somaproject/network/docs/README

Docs organization

Commentary
IO: 
   Data input/output
   Serial interface
Implementation -- FPGA
implementation -- PCB
