somaproject/network/docs/tx/tx.tex

\section{Packet Transmission}
Packet transmission takes a packet from the generic interface and
places it on the wire via the GMII interface.

\import{.}{txinput.tex}

\import{.}{txoutput.tex}
