somaproject/network/docs/control/control.tex

\section{NIC Control}
NIC control manages

1. The management interface to the PHY
2. counters for various sytem-wide events
3. packet filtering and rx filtering
4. system LED illumination
5. the general serial management interface

The serial interface and address values for the NIC are described in the section {NIC Serial management protocol}

\subsection{implementation}
