somaproject/network/docs/rx/rxvalid.tex

The RXValid module reads in the data associated with a new frame a
byte at a time, and compares the destination MAC address to the
broadcast, multicast, and self-mac addresses. If the control inputs
allow for reception of the recovered MAC address, \signal{DESTOK} is
asserted. 

\begin{figure}
\label{rxvalid}

\caption{The RX Valid Interface, verifying correct packets}

\end{figure}

\begin{figure}
\label{rxvalidfsm}

\caption{The RX Valid FSM, verifying correct packets}
\end{figure}
