somaproject/network/docs/network.bomdb.ods

Network Project Summary
Total Device Count |  |  | 1
Quant | Desc | Vendor | Package | Val | Tol | Total | Distributor | Qty
57 | C0603C104J4RACTU | Kemet | 0603 | 0.1uF | 5% | 57
16 | C0402C103K3RACTU | Kemet | 0402 | 0.01uF | 10% | 16
11 | LTST-C170TBKT | Lumex | 0805 |  |  | 11
1 | 87832-1420 | Molex |  |  |  | 1
1 | ECS-3953M-500-B-TR | ECS, Inc | SMT |  |  | 1
1 | TPS79518DCQR | Texas Instruments | SOT-223-5 |  |  | 1
2 | TPS79525DCQ | Texas Instruments | SOT-223-5 |  |  | 2
1 | TPS79501DCQR | Texas Instruments | SOT-223-5 |  |  | 1
1 | 44050-0007 | Molex | RJ45 |  |  | 1
1 | H5007NL | Pulse | 24SOIC |  |  | 1
1 | DP83865DVH | National Semiconductor | 128PQFP |  |  | 1
1 | CY7C1350G-200AXC | Cypress | 100PQFP |  |  | 1
1 | XC3S200-4PQG208C | Xilinx | 208PQFP |  |  | 1
1 | MA-506 25.0000M-C0 | Epson Electronics America Inc | SMD |  |  | 1
2 | ECJ-1VC1H080D |  | 0603 | 8pF |  | 2
1 | MCR03EZPFX9761 | Rohm | 0603 | 9.76k | 1% | 1
4 | MCR03EZPFX3830 | Rohm | 0603 | 383 | 1% | 4
15 | ERJ-3EKF49R9V | Panasonic - ECG | 0603 | 49.9 | 1% | 15
7 | RC0603FR-072KL | Yaego America | 0603 | 2.00k | 1% | 7
4 | RC0603FR-0775RL | Yaego America | 0603 | 75 | 1% | 4
1 | RC0603FR-0710KL | Yaego America | 0603 | 10.0k | 1% | 1
1 | RC0603FR-0718RL | Yaego America | 0603 | 18.0 | 1% | 1
4 | GRM31MR71A225MA01L | muRata | 1206 | 2.2uF |  | 4
1 | TAJD226K025R | AVX corporation | 7343 | 22uF | 10% | 1
8 | TAJC106K020R | AVX corporation | 6032 | 10uF | 10% | 8
4 | B45197A2107K309 | Kemet | 6032 | 100uF | 10% | 4
1 | PPTC282LFBN-RC |  |  |  |  | 1
