somaproject/network/tests/blink/README

A test to blink the LEDs of the interface, to test booting.
