somaproject/network/tests/simplememtest/README

A simple test of our memory IO, to make sure all pins are functioning
properly and the like. 

The readout is accomplished via the JTAG BSCAN block on USER1.

We alternate read-write and then make sure we're reading/writing from
the correct location/value. The verify check is located one cycle in
the future.

Originally ported from code we had written for the backplane.
