somaproject/network/sim/components/GMII/results.txt

Error at time=724796ps MDIO=1, Expected = 0 
No errors or warnings
