somaproject/network/(list of files, drawings)

Other design files:
pcb/FPGA.SCHDOC
pcb/MAIN.SCHDOC
pcb/memory.SCHDOC
pcb/Network Interface.PRJPCB
pcb/NIC.PCBDOC
pcb/outputs/BOM.html-Network Interface.PRJPCB
pcb/outputs/BOM.text-Network Interface.PRJPCB
pcb/outputs/BOM.xls-Network Interface.PRJPCB
pcb/parts.PCBLIB
pcb/parts.SCHLIB
pcb/PHY.SCHDOC
pcb/Power and Clocks.SCHDOC
