somaproject/network/vhdl/network.vhd

library IEEE;
use IEEE.STD_LOGIC_1164.all;
use IEEE.STD_LOGIC_ARITH.all;
use IEEE.STD_LOGIC_UNSIGNED.all;

library UNISIM;
use UNISIM.VComponents.all;

entity network is
  port ( CLKIN     : in    std_logic;
         RX_DV     : in    std_logic;
         RX_ER     : in    std_logic;
         RXD       : in    std_logic_vector(7 downto 0);
         RX_CLK    : in    std_logic;
         TXD       : out   std_logic_vector(7 downto 0);
         TX_EN     : out   std_logic;
         GTX_CLK   : out   std_logic;
         MA        : out   std_logic_vector(16 downto 0);
         MD        : inout std_logic_vector(31 downto 0);
         MCLK      : out   std_logic;
         MWE       : out   std_logic;
         CLKIOIN   : in    std_logic;
         NEXTFRAME : in    std_logic;
         DOUT      : out   std_logic_vector(15 downto 0);
         DOUTEN    : out   std_logic;
         NEWFRAME  : in    std_logic;
         DIN       : in    std_logic_vector(15 downto 0);
         MDIO      : inout std_logic;
         MDC       : out   std_logic;
         LEDACT    : out   std_logic;
         LEDTX     : out   std_logic;
         LEDRX     : out   std_logic;
         LED100    : out   std_logic;
         LED1000   : out   std_logic;
         LEDDPX    : out   std_logic;
         LEDPOWER  : out   std_logic;
         PHYRESET  : out   std_logic;
         SCLK      : in    std_logic;
         SIN       : in    std_logic;
         SOUT      : out   std_logic;
         SCS       : in    std_logic);
end network;

architecture Behavioral of network is


  -- clock and timing signals
  signal clk, clkio, clklo, clkrx             : std_logic := '0';
  signal clkint, clkioint, clkloint, clkrxint : std_logic := '0';
  signal clkb, clkbint                        : std_logic := '0';
  signal clkf, clkfint                        : std_logic := '0';

  signal clk90, clk90int   : std_logic := '0';
  signal clk180, clk180int : std_logic := '0';
  signal clk270, clk270int : std_logic := '0';

  signal mclkint, mclkintfb : std_logic := '0';

  signal clken1, clken2, clken3, clken4 : std_logic := '0';

  -- data
  signal d1, d2, d3, d4, q1, q2, q3, q4 :
    std_logic_vector(31 downto 0) := (others => '0');

  -- addresses
  signal addr1 : std_logic_vector(15 downto 0) := (others => '0');
  signal addr2 : std_logic_vector(15 downto 0) := (others => '0');
  signal addr3 : std_logic_vector(15 downto 0) := (others => '0');
  signal addr4 : std_logic_vector(15 downto 0) := (others => '0');

  signal addr1ext : std_logic_vector(16 downto 0) := (others => '0');
  signal addr2ext : std_logic_vector(16 downto 0) := (others => '0');
  signal addr3ext : std_logic_vector(16 downto 0) := (others => '0');
  signal addr4ext : std_logic_vector(16 downto 0) := (others => '0');

  -- error and status signals
  signal rxcrcerr, rxoferr, rxphyerr, rxf, txf,
    txi_mwen, txfifowerr, rxfifowerr :
    std_logic := '0';


-- base pointers
  signal rxbp, txbp     : std_logic_vector(15 downto 0) :=
    (others => '0');
  signal txfbbp, rxfbbp : std_logic_vector(15 downto 0) :=
    (others => '0');
  signal txinmwen       : std_logic                     := '0';

  -- fifo control
  signal txfifofull, rxfifofull : std_logic := '0';

  -- mac address filtering
  signal rxmcast, rxbcast, rxucast, rxallf : std_logic := '0';

  signal macaddr : std_logic_vector(47 downto 0) := (others => '0');

  -- memory read/write error
  signal rxmemcrcerr, txmemcrcerr : std_logic := '0';
  signal txiocrcerr               : std_logic := '0';
  signal txiocrcerrpos : std_logic_vector(15 downto 0) := (others => '0');
  

  signal reset      : std_logic := '0';
  signal hilocked   : std_logic := '0';
  signal hireset    : std_logic := '1';
  signal multlocked : std_logic := '0';
  signal multreset  : std_logic := '1';


  component memory
    port ( CLK     : in    std_logic;
           RESET   : in    std_logic;
           DQEXT   : inout std_logic_vector(31 downto 0);
           WEEXT   : out   std_logic;
           ADDREXT : out   std_logic_vector(16 downto 0);
           ADDR1   : in    std_logic_vector(16 downto 0);
           ADDR2   : in    std_logic_vector(16 downto 0);
           ADDR3   : in    std_logic_vector(16 downto 0);
           ADDR4   : in    std_logic_vector(16 downto 0);
           D1      : in    std_logic_vector(31 downto 0);
           D2      : in    std_logic_vector(31 downto 0);
           D3      : in    std_logic_vector(31 downto 0);
           D4      : in    std_logic_vector(31 downto 0);
           Q1      : out   std_logic_vector(31 downto 0);
           Q2      : out   std_logic_vector(31 downto 0);
           Q3      : out   std_logic_vector(31 downto 0);
           Q4      : out   std_logic_vector(31 downto 0);
           WE1     : in    std_logic;
           WE2     : in    std_logic;
           WE3     : in    std_logic;
           WE4     : in    std_logic;
           CLKEN1  : out   std_logic;
           CLKEN2  : out   std_logic;
           CLKEN3  : out   std_logic;
           CLKEN4  : out   std_logic);
  end component;

  component RXinput
    port ( RX_CLK     : in  std_logic;
           CLK        : in  std_logic;
           RESET      : in  std_logic;
           RX_DV      : in  std_logic;
           RX_ER      : in  std_logic;
           RXD        : in  std_logic_vector(7 downto 0);
           MD         : out std_logic_vector(31 downto 0);
           MA         : out std_logic_vector(15 downto 0);
           BPOUT      : out std_logic_vector(15 downto 0);
           RXCRCERR   : out std_logic;
           RXOFERR    : out std_logic;
           RXPHYERR   : out std_logic;
           RXFIFOWERR : out std_logic;
           FIFOFULL   : in  std_logic;
           RXF        : out std_logic;
           MACADDR    : in  std_logic_vector(47 downto 0);
           RXBCAST    : in  std_logic;
           RXMCAST    : in  std_logic;
           RXUCAST    : in  std_logic;
           RXALLF     : in  std_logic);
  end component;

  component RXoutput
    port ( CLK       : in  std_logic;
           CLKEN     : in  std_logic;
           RESET     : in  std_logic;
           BPIN      : in  std_logic_vector(15 downto 0);
           FBBP      : out std_logic_vector(15 downto 0);
           MA        : out std_logic_vector(15 downto 0);
           MQ        : in  std_logic_vector(31 downto 0);
           CLKIO     : in  std_logic;
           MEMCRCERR : out std_logic;

           NEXTFRAME : in  std_logic;
           DOUT      : out std_logic_vector(15 downto 0);
           DOUTEN    : out std_logic);
  end component;

  component TXoutput
    port ( CLK       : in  std_logic;
           RESET     : in  std_logic;
           MQ        : in  std_logic_vector(31 downto 0);
           MA        : out std_logic_vector(15 downto 0);
           BPIN      : in  std_logic_vector(15 downto 0);
           TXD       : out std_logic_vector(7 downto 0);
           TXEN      : out std_logic;
           TXF       : out std_logic;
           MEMCRCERR : out std_logic;
           FBBP      : out std_logic_vector(15 downto 0);
           CLKEN     : in  std_logic);
  end component;

  component TXinput
    port ( CLK        : in  std_logic;
           CLKIO      : in  std_logic;
           RESET      : in  std_logic;
           DIN        : in  std_logic_vector(15 downto 0);
           NEWFRAME   : in  std_logic;
           MD         : out std_logic_vector(31 downto 0);
           MWEN       : out std_logic;
           MA         : out std_logic_vector(15 downto 0);
           BPOUT      : out std_logic_vector(15 downto 0);
           FIFOFULL   : in  std_logic;
           TXFIFOWERR : out std_logic;
           TXIOCRCERR : out std_logic;
           TXIOCRCERRPOS : out std_Logic_vector(15 downto 0); 
           DONE       : out std_logic);
  end component;

  component FIFOcheck
    port ( CLK      : in  std_logic;
           BP       : in  std_logic_vector(15 downto 0);
           FBBP     : in  std_logic_vector(15 downto 0);
           FIFOFULL : out std_logic);
  end component;

  component control
    port ( CLK         : in    std_logic;
           CLKLO       : in    std_logic;
           RESET       : in    std_logic;
           SCLK        : in    std_logic;
           SCS         : in    std_logic;
           SIN         : in    std_logic;
           SOUT        : out   std_logic;
           LEDACT      : out   std_logic;
           LEDTX       : out   std_logic;
           LEDRX       : out   std_logic;
           LED100      : out   std_logic;
           LED1000     : out   std_logic;
           LEDDPX      : out   std_logic;
           PHYRESET    : out   std_logic;
           TXF         : in    std_logic;
           RXF         : in    std_logic;
           TXFIFOWERR  : in    std_logic;
           RXFIFOWERR  : in    std_logic;
           RXPHYERR    : in    std_logic;
           RXOFERR     : in    std_logic;
           TXMEMCRCERR : in    std_logic;
           RXMEMCRCERR : in    std_logic;
           TXIOCRCERR  : in    std_logic;
           TXIOCRCERRPOS : in std_logic_vector(15 downto 0); 
           RXCRCERR    : in    std_logic;
           RXBCAST     : out   std_logic;
           RXMCAST     : out   std_logic;
           RXUCAST     : out   std_logic;
           RXALLF      : out   std_logic;
           MACADDR     : out   std_logic_vector(47 downto 0);
           MDIO        : inout std_logic;
           MDC         : out   std_logic;
           RXBP        : in    std_logic_vector(15 downto 0);
           TXBP        : in    std_logic_vector(15 downto 0);
           RXFBBP      : in    std_logic_vector(15 downto 0);
           TXFBBP      : in    std_logic_vector(15 downto 0));
  end component;

  signal memlocked, memreset : std_logic := '0';

  -- debugging :
  signal doutensig      : std_logic                     := '0';
  signal debugdouten    : std_logic                     := '0';
  signal debugnextframe : std_logic                     := '0';
  signal debugdout      : std_logic_vector(15 downto 0) := (others => '0');

  component datagen
    port (
      CLK       : in  std_logic;
      NEXTFRAME : in  std_logic;
      DOUTEN    : out std_logic;
      DOUT      : out std_logic_vector(15 downto 0)
      );
  end component;

begin

  DOUTEN <= doutensig;

  LEDPOWER <= '1';

  addr1ext <= ('1' & addr1);
  addr2ext <= ('0' & addr2);
  addr3ext <= ('1' & addr3);
  addr4ext <= ('0' & addr4);




  clkio_dcm : DCM
    port map (
      CLK0  => clkioint,                -- 0 degree DCM CLK ouptput
      CLKFB => clkio,                   -- DCM clock feedback
      CLKIN => CLKIOIN,
      RST   => RESET
      );

  clkio_bufg : BUFG
    port map (
      I => clkioint,
      O => clkio);


  clk_dcm : DCM
    generic map (
      CLKDV_DIVIDE   => 2.0,
      CLKFX_MULTIPLY => 5,
      CLKFX_DIVIDE   => 2)
    port map (
      CLK0           => clkbint,        -- 50 MHz dummy feedback loop
      CLKFB          => clkb,           -- 
      CLKIN          => CLKIN,
      CLKDV          => clkloint,
      CLKFX          => clkfint,        -- 125 Mhz generated clock
      RST            => '0',
      LOCKED         => multlocked
      );

  multreset <= not multlocked;

  clkhi_dcm : DCM
    port map (
      CLK0   => clkint,                 -- 0 degree DCM CLK ouptput
      CLKFB  => clk,                    -- DCM clock feedback
      CLK180 => clk180int,
      CLK90  => clk90int,
      CLK270 => clk270int,
      CLKIN  => clkf,
      RST    => multreset,
      LOCKED => hilocked
      );

  hireset <= not hilocked;


  clkf_bufg : BUFG port map (
    I => clkfint,
    O => clkf);

  clkb_bufg : BUFG port map (
    I => clkbint,
    O => clkb);

  clk_bufg : BUFG port map (
    I => clkint,
    O => clk);

  clklo_bufg : BUFG port map (
    I => clkloint,
    O => clklo);


  clk180_bufg : BUFG port map (
    I => clk180int,
    O => clk180 );

  U2 : OBUF port map (I => clk180, O => GTX_CLK);

  clkrx_bufg : BUFG port map (
    I => RX_CLK,
    O => clkrx);

  clkmem_dcm : DCM
    generic map (
      CLKOUT_PHASE_SHIFT => "FIXED",
      PHASE_SHIFT        => 100 )
    port map (
      CLK0               => mclkintfb,
      CLKFB              => mclkint,
      CLKIN              => clk,
      RST                => hireset,
      locked             => memlocked
      );
  memreset <= not memlocked;
  RESET    <= memreset;

  clkmem_bufg : BUFG port map (
    I => mclkintfb,
    O => mclkint);

  MCLK <= mclkint;

  memcontroller : memory port map (
    CLK     => clk,
    RESET   => RESET,
    DQEXT   => MD,
    WEEXT   => MWE,
    ADDREXT => MA,
    ADDR1   => addr1ext,
    ADDR2   => addr2ext,
    ADDR3   => addr3ext,
    ADDR4   => addr4ext,
    D1      => d1,
    D2      => d2,
    D3      => d3,
    D4      => d4,
    Q1      => q1,
    Q2      => q2,
    Q3      => q3,
    Q4      => q4,
    WE1     => '1',
    WE2     => '0',
    WE3     => '0',
    WE4     => '1',
    CLKEN1  => clken1,
    CLKEN2  => clken2,
    CLKEN3  => clken3,
    CLKEN4  => clken4);

  rx_input : rxinput port map (
    RX_CLK     => clkrx,
    CLK        => clk,
    RESET      => RESET,
    RX_DV      => RX_DV,
    RX_ER      => RX_ER,
    RXD        => RXD,
    MD         => d1,
    MA         => addr1,
    BPOUT      => rxbp,
    RXCRCERR   => rxcrcerr,
    RXOFERR    => rxoferr,
    RXPHYERR   => rxphyerr,
    FIFOFULL   => rxfifofull,
    RXFIFOWERR => rxfifowerr,
    RXF        => rxf,
    MACADDR    => macaddr,
    RXBCAST    => rxbcast,
    RXMCAST    => rxmcast,
    RXUCAST    => rxucast,
    RXALLF     => rxallf);

  rx_output : rxoutput port map (
    CLK       => clk,
    CLKEN     => clken3,
    RESET     => RESET,
    BPIN      => rxbp,
    FBBP      => rxfbbp,
    MA        => addr3,
    MQ        => q3,
    MEMCRCERR => rxmemcrcerr,
    CLKIO     => clkio,
    NEXTFRAME => NEXTFRAME,
    DOUT      => DOUT,
    DOUTEN    => doutensig);

  tx_output : txoutput
    port map (
      CLK       => clk,
      RESET     => reset,
      MQ        => q2,
      MA        => addr2,
      BPIN      => txbp,
      TXD       => TXD,
      TXEN      => TX_EN,
      TXF       => txf,
      MEMCRCERR => txmemcrcerr,
      FBBP      => txfbbp,
      CLKEN     => clken2);

  txinput_inst : txinput
    port map (
      CLK        => clk,
      CLKIO      => clkio,
      RESET      => reset,
      DIN        => DIN,
      NEWFRAME   => NEWFRAME,
      MWEN       => txinmwen,
      MA         => addr4,
      MD         => d4,
      BPOUT      => txbp,
      FIFOFULL   => txfifofull,
      TXFIFOWERR => txfifowerr,
      TXIOCRCERR => txiocrcerr,
      TXIOCRCERRPOS => txiocrcerrpos, 
      DONE       => open);

  tx_fifocheck : FIFOcheck port map(
    CLK      => clk,
    FIFOFULL => txfifofull,
    BP       => txbp,
    FBBP     => txfbbp);

  rx_fifocheck : FIFOcheck port map(
    CLK      => clk,
    FIFOFULL => rxfifofull,
    BP       => rxbp,
    FBBP     => rxfbbp);

  maccontrol : control port map (
    CLK         => clk,
    CLKLO       => clklo,
    RESET       => RESET,
    SCLK        => SCLK,
    SCS         => SCS,
    SIN         => SIN,
    SOUT        => SOUT,
    LEDACT      => LEDACT,
    LEDTX       => LEDTX,
    LEDRX       => LEDRX,
    LED100      => LED100,
    LED1000     => LED1000,
    LEDDPX      => LEDDPX,
    PHYRESET    => PHYRESET,
    TXF         => txf,
    RXF         => rxf,
    TXFIFOWERR  => txfifowerr,
    RXFIFOWERR  => rxfifowerr,
    RXPHYERR    => rxphyerr,
    RXOFERR     => rxoferr,
    RXCRCERR    => rxcrcerr,
    RXBCAST     => rxbcast,
    RXMCAST     => rxmcast,
    RXUCAST     => rxucast,
    RXALLF      => rxallf,
    RXMEMCRCERR => rxmemcrcerr,
    TXMEMCRCERR => txmemcrcerr,
    TXIOCRCERR  => txiocrcerr,
    TXIOCRCERRPOS => txiocrcerrpos, 
    MACADDR     => macaddr,
    MDIO        => MDIO,
    MDC         => MDC,
    RXBP        => rxbp,
    TXBP        => txbp,
    RXFBBP      => rxfbbp,
    TXFBBP      => txfbbp);




end Behavioral;
