somaproject/network/ping/vhdl/rambuffer.vhd

library IEEE;
use IEEE.STD_LOGIC_1164.ALL;
use IEEE.STD_LOGIC_ARITH.ALL;
use IEEE.STD_LOGIC_UNSIGNED.ALL;

--  Uncomment the following lines to use the declarations that are
--  provided for instantiating Xilinx primitive components.
library UNISIM;
use UNISIM.VComponents.all;

entity rambuffer is
    Port ( CLK : in std_logic;
	 		  RESET : in std_logic; 
           DIN : in std_logic_vector(15 downto 0);
           DOUT : out std_logic_vector(15 downto 0);
           WE : in std_logic;
           ADDR : in std_logic_vector(10 downto 0));
end rambuffer;

architecture Behavioral of rambuffer is
-- RAMBUFFER.VHD -- simple wrapper around BlockSelect+ RAMs to make a 1536x16 ram. 

	signal raddr : std_logic_vector(7 downto 0) := (others => '0');
	signal we0, we1, we2, we3, we4, we5 : std_logic := '0';
	signal dout0, dout1, dout2, dout3, dout4, dout5 : 
			std_logic_vector(15 downto 0) := (others => '0');


	component RAMB4_S16
	  generic (
	       INIT_00 : bit_vector := X"0000000000000000000000000000000000000000000000000000000000000000";
	       INIT_01 : bit_vector := X"0000000000000000000000000000000000000000000000000000000000000000";
	       INIT_02 : bit_vector := X"0000000000000000000000000000000000000000000000000000000000000000";
	       INIT_03 : bit_vector := X"0000000000000000000000000000000000000000000000000000000000000000";
	       INIT_04 : bit_vector := X"0000000000000000000000000000000000000000000000000000000000000000";
	       INIT_05 : bit_vector := X"0000000000000000000000000000000000000000000000000000000000000000";
	       INIT_06 : bit_vector := X"0000000000000000000000000000000000000000000000000000000000000000";
	       INIT_07 : bit_vector := X"0000000000000000000000000000000000000000000000000000000000000000";
	       INIT_08 : bit_vector := X"0000000000000000000000000000000000000000000000000000000000000000";
	       INIT_09 : bit_vector := X"0000000000000000000000000000000000000000000000000000000000000000";
	       INIT_0A : bit_vector := X"0000000000000000000000000000000000000000000000000000000000000000";
	       INIT_0B : bit_vector := X"0000000000000000000000000000000000000000000000000000000000000000";
	       INIT_0C : bit_vector := X"0000000000000000000000000000000000000000000000000000000000000000";
	       INIT_0D : bit_vector := X"0000000000000000000000000000000000000000000000000000000000000000";
	       INIT_0E : bit_vector := X"0000000000000000000000000000000000000000000000000000000000000000";
	       INIT_0F : bit_vector := X"0000000000000000000000000000000000000000000000000000000000000000");

	  port (DI     : in STD_LOGIC_VECTOR (15 downto 0);
	        EN     : in STD_logic;
	        WE     : in STD_logic;
	        RST    : in STD_logic;
	        CLK    : in STD_logic;
	        ADDR   : in STD_LOGIC_VECTOR (7 downto 0);
	        DO     : out STD_LOGIC_VECTOR (15 downto 0)); 
	end component;

	

begin
	raddr <= ADDR(7 downto 0); 
	we0 <= '1' when WE = '1' and ADDR(9 downto 7) = "000" else '0';
	we1 <= '1' when WE = '1' and ADDR(9 downto 7) = "001" else '0';
	we2 <= '1' when WE = '1' and ADDR(9 downto 7) = "010" else '0';
	we3 <= '1' when WE = '1' and ADDR(9 downto 7) = "011" else '0';
	we4 <= '1' when WE = '1' and ADDR(9 downto 7) = "100" else '0';
	we5 <= '1' when WE = '1' and ADDR(9 downto 7) = "101" else '0';

	process(CLK) is
	variable addrlsub : std_logic_vector(2 downto 0); 
	begin
	  if rising_edge(CLK) then 
	  		addrlsub := ADDR(9 downto 7); 
		end if; 
	      case addrlsub is
				when "000" => DOUT <= dout0; 
				when "001" => DOUT <= dout0; 
				when "010" => DOUT <= dout0; 
				when "011" => DOUT <= dout0; 
				when "100" => DOUT <= dout0; 
				when "101" => DOUT <= dout0; 
				when others => DOUT <= (others => '0');
			end case; 

   end process; 
	ram0 : RAMB4_S16 generic map (
				INIT_00 => X"0000000000000000000000000000000000000000000000000000000000000000",
				INIT_01 => X"0000000000000000000000000000000000000000000000000000000000000000",
				INIT_02 => X"0000000000000000000000000000000000000000000000000000000000000000",
				INIT_03 => X"0000000000000000000000000000000000000000000000000000000000000000",
				INIT_04 => X"0000000000000000000000000000000000000000000000000000000000000000",
				INIT_05 => X"0000000000000000000000000000000000000000000000000000000000000000",
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
				INIT_0F => X"0000000000000000000000000000000000000000000000000000000000000000")
				port map (
				DI => DIN,
				EN => '1',
				WE => we5,
				RST => RESET,
				CLK => CLK,
				ADDR => raddr,
				DO => dout5); 

				
				 




end Behavioral;
