somaproject/network/vhdl/rxvalid.vhd

library IEEE;
use IEEE.STD_LOGIC_1164.all;
use IEEE.STD_LOGIC_ARITH.all;
use IEEE.STD_LOGIC_UNSIGNED.all;

entity RXValid is
  port ( CLK     : in  std_logic;
         RESET   : in  std_logic;
         DATA    : in  std_logic_vector(7 downto 0);
         MACADDR : in  std_logic_vector(47 downto 0);
         RXBCAST : in  std_logic;
         RXMCAST : in  std_logic;
         RXUCAST : in  std_logic;
         RXALLF  : in  std_logic;
         DESTOK  : out std_logic;
         FD      : in  std_logic;
         NEXTF   : in  std_logic);
end RXValid;

architecture Behavioral of RXValid is
-- RXVALID.VHD
-- latches in the DEST MAC and determines
-- if we should receive this frame

  -- MAC latching
  signal datal       : std_logic_vector(47 downto 0)
                                                    := (others => '0');
  signal bcast, mcast, maceq, lbcast, lmcast, lmaceq
                     : std_logic_vector(5 downto 0) := (others => '0');
  signal fdl, nextfl : std_logic                    := '0';
  signal dl          : std_logic_vector(7 downto 0)
                                                    := (others => '0');
  -- input latching
  signal macaddrl    : std_logic_vector(47 downto 0)
                                                    := (others => '0');
  signal rxbcastl, rxucastl, rxmcastl, rxallfl
                     : std_logic                    := '0';
  signal validbcast, validmcast, validucast
                     : std_logic                    := '0';

  type states is (none, byte0, byte1,
                  byte2, byte3, byte4, byte5);
  signal cs, ns : states := none;


begin
  clock : process(RESET, CLK)
  begin
    if RESET = '1' then
      cs   <= none;
    else
      if rising_edge(CLK) then
        cs <= ns;

        -- inputs
        macaddrl <= MACADDR;
        rxbcastl <= RXBCAST;
        rxmcastl <= RXMCAST;
        rxucastl <= RXUCAST;
        rxallfl  <= RXALLF;

        -- valids
        if bcast = "111111" then
          validbcast <= '1';
        else
          validbcast <= '0';
        end if;

        if mcast(0) = '1' then
          validmcast <= '1';
        else
          validmcast <= '0';
        end if;

        if maceq = "111111" then
          validucast <= '1';
        else
          validucast <= '0';
        end if;

        if (validbcast = '1' and rxbcastl = '1')
          or (validmcast = '1' and rxmcastl = '1')
          or (validucast = '1' and rxucastl = '1')
          or rxallfl = '1' then
          DESTOK <= '1';
        else
          DESTOK <= '0';
        end if;

        -- comparisons
        bcast  <= lbcast;
        mcast  <= lmcast;
        maceq  <= lmaceq;
        dl     <= DATA;
        fdl    <= FD;
        nextfl <= NEXTF;

        if cs = byte0 and fdl = '1' then
          datal(47 downto 40) <= dl;
        end if;
        if cs = byte1 and fdl = '1' then
          datal(39 downto 32) <= dl;
        end if;
        if cs = byte2 and fdl = '1' then
          datal(31 downto 24) <= dl;
        end if;
        if cs = byte3 and fdl = '1' then
          datal(23 downto 16) <= dl;
        end if;
        if cs = byte4 and fdl = '1' then
          datal(15 downto 8)  <= dl;
        end if;
        if cs = byte5 and fdl = '1' then
          datal(7 downto 0)   <= dl;
        end if;
      end if;
    end if;
  end process clock;


  comparisons : for n in 0 to 5 generate
  begin
    lbcast(n) <= '1' when
                 datal(47 - 8*n downto 40 - 8*n) = "11111111" else '0';
    lmcast(n) <= '1' when
                 datal(47 - 8*n downto 40 - 8*n) = "00000001" else '0';
    lmaceq(n) <= '1' when
                 datal(47 - 8*n downto 40 - 8*n) =
                 macaddrl(47 - 8*n downto 40 - 8*n)
                 else '0';
  end generate;


  fsm : process(cs, nextfl, fdl) is
  begin
    case cs is
      when none   =>
        if nextfl = '1' then
          ns   <= byte0;
        else
          ns   <= none;
        end if;
      when byte0  =>
        if nextfl = '1' then
          ns   <= byte0;
        else
          if fdl = '1' then
            ns <= byte1;
          else
            ns <= byte0;
          end if;
        end if;
      when byte1  =>
        if nextfl = '1' then
          ns   <= byte0;
        else
          if fdl = '1' then
            ns <= byte2;
          else
            ns <= byte1;
          end if;
        end if;
      when byte2  =>
        if nextfl = '1' then
          ns   <= byte0;
        else
          if fdl = '1' then
            ns <= byte3;
          else
            ns <= byte2;
          end if;
        end if;
      when byte3  =>
        if nextfl = '1' then
          ns   <= byte0;
        else
          if fdl = '1' then
            ns <= byte4;
          else
            ns <= byte3;
          end if;
        end if;
      when byte4  =>
        if nextfl = '1' then
          ns   <= byte0;
        else
          if fdl = '1' then
            ns <= byte5;
          else
            ns <= byte4;
          end if;
        end if;
      when byte5  =>
        if nextfl = '1' then
          ns   <= byte0;
        else
          if fdl = '1' then
            ns <= none;
          else
            ns <= byte5;
          end if;
        end if;
      when others =>
        ns     <= none;
    end case;
  end process fsm;

end Behavioral;
