somaproject/network/sim/txoutput/txoutput.py

#!/usr/bin/python


import sys
sys.path.append("../../crc/code/")
import frame
import random
import struct
import numpy


def generateCRC(data):
    """ Takes in data and appends the crc

    """
    # create the string:
    d = ""
    for i in data:
        d += chr(i)
        
    fcs = frame.generateFCS(d)
    
    return [ord(fcs[0]),  ord(fcs[1]), ord(fcs[2]), ord(fcs[3])]

filename = "basic"

ramfile = file("%s.ram.dat" % filename, 'w')
bpfile = file("%s.bp.dat" % filename, 'w')
gmiifile = file("%s.gmii.dat" % filename, 'w')

ramaddr = 0; 

for i in range(255):
    crcerror = False
    if random.random() > 0.85:
        crcerror = True
    framedatalen = i + 56
        
    framedata = range(framedatalen)

    for i in range(framedatalen):
        framedata[i] = i % 256 #random.randint(0, 255)

    destmacaddr = range(6)
    srcmacaddr =  range(6)
    for i in range(6):
        destmacaddr[i] = random.randint(0, 255)
        srcmacaddr[i] = random.randint(0, 255)

    protocol = [8, 0]
        
    
    totaldata = destmacaddr + srcmacaddr + protocol + framedata
    crc = generateCRC(totaldata)
    totaldata = totaldata + crc
    totallen = len(totaldata)
    totaldata += [0, 0, 0, 0] # extra padding so ram write has enough to add
    if crcerror:
        print "generating a CRC error"
        totaldata[5] += 1
    
    # write the current ram address as a bp
    bpfile.write("%d %d %d\n" % (ramaddr, totallen, crcerror))


    # write the ram :
    
    ramfile.write("%04X %08X\n" % (ramaddr, totallen))
    ramaddr += 1
    
    for i in range((totallen+3) / 4) : # extra +3 such that odd lens work
        
        ramfile.write("%04X %02X%02X%02X%02X\n" % (ramaddr,
                                             totaldata[i*4+2],
                                             totaldata[i*4+3],
                                             totaldata[i*4+0],
                                             totaldata[i*4+1]))
        ramaddr += 1

    # GMII output
    totalbindata = ""
    for i in (framedata) :
        totalbindata += struct.pack("B", i)
    
    f = frame.frame(destmacaddr, srcmacaddr, 0x0800, totalbindata)
    framebin = f.getWire()
    for i in framebin:
        gmiifile.write('%02X ' % struct.unpack('B', i)[0])

    gmiifile.write('\n')

    
