somaproject/network/sim/components/NoBLram/NoBLSRAM.vhd

library IEEE;
use IEEE.STD_LOGIC_1164.all;
use ieee.numeric_std.all;
use std.textio.all;

use ieee.std_logic_textio.all;

library UNISIM;
use UNISIM.VComponents.all;

entity NoBLSRAM is
  generic ( FILEIN       :       string  := "SRAM_in.dat";
            FILEOUT      :       string  := "SRAM_out.dat";
            physical_sim :       integer := 0;
            TSU          :       time;
            THD          :       time;
            TKQ          :       time;
            TKQX         :       time);
  port ( CLK             : in    std_logic;
         DQ              : inout std_logic_vector(31 downto 0);
         ADDR            : in    std_logic_vector(16 downto 0);
         WE              : in    std_logic;
         RESET           : in    std_logic;
         SAVE            : in    std_logic);
end NoBLSRAM;

architecture Behavioral of NoBLSRAM is
-- another ram simulation. filein is our input file, fileout is
-- where we save to. filein is read on startup, fileout is
-- saved. This is ram designed to behave like Cypresses NoBL
-- (i.e. micron ZBT) sync SRAM
  subtype word is std_logic_vector(31 downto 0);

  type storage_array is
    array ( 0 to 131071) of word;

  signal IN_SIG, OUT_SIG, T_ENABLE :       std_logic;
  component IOBUF
    port (I, T                     : in    std_logic;
          O                        : out   std_logic;
          IO                       : inout std_logic);
  end component;
  signal din, dout                 :       word := (others => '0');

  signal lladdr, laddr, addr_now : std_logic_vector(16 downto 0) := (others => '0');
  signal llwe, lwe, we_now       : std_logic                     := '1';

-- times, from cypress 133 MHz part:


begin

  buffs        : for i in 0 to 31 generate
    buffs_inst : iobuf port map (
      I  => dout(i),
      O  => din(i),
      IO => DQ(i),
      T  => T_ENABLE);

  end generate;


  process(clk)
  begin

    if rising_edge(clk'delayed(THD)) then
      assert DQ'last_event >= THD
        report("Hold violation on DQ");
    end if;

  end process;

  -- cancel timings if this isn't a physical simulation



  main : process

    type load_file_type is file of word;
    type save_file_type is file of word;
    file load_file  : text open read_mode is FILEIN;
    file save_file  : text open write_mode is FILEOUT;
    variable WL, RL : line;

    variable index      : natural;
    variable dword      : bit_vector(31 downto 0);
    variable SRAM       : storage_array := (others => "00000000000000000000000000000000");
    variable numaddress : integer       := 0;


  begin
    wait until falling_edge(RESET);
    index     := 0;
    for i in 0 to 131071 loop
      SRAM(i) := (others => '0');       -- zero sram
    end loop;

    while not endfile(load_file) loop
      readline(load_file, RL);
      read(RL, dword);
      SRAM(index) := to_x01(dword);
      index       := index + 1;
    end loop;


    -- falling edge starts cmd; read in 8 bits, then decide what to do
    while true loop
      wait until rising_edge(CLK) or rising_edge(SAVE);
      if rising_edge(SAVE) then
        for i in 0 to 131071 loop
          write (WL, to_bitvector(SRAM(i)));
          write(WL, character(' '));
          hwrite(WL, SRAM(i));
          writeline(save_file, WL);

        end loop;
      end if;
      if rising_edge(CLK) then


        if physical_sim = 1 then
          assert(din'last_event >= TSU);
          report ("setup violation on din");
        end if;
        numaddress := to_integer(unsigned(laddr));
        dout <= (others => 'U')  after TKQX;
        dout <= SRAM(numaddress) after TKQ;

        T_ENABLE <= (not lwe) after 0 ns;

        if llwe = '0' then              -- a write
          --report "Writing to " & integer'image(to_integer(unsigned(lladdr)));
          --report "value = " & integer'image(to_integer(unsigned(din)));
          SRAM(to_integer(unsigned(lladdr))) := din;
        end if;

      end if;
    end loop;

    wait;

  end process main;

  clock : process(CLK)
  begin
    if rising_edge(CLK) then
      llwe <= lwe;
      lwe  <= WE;

      lladdr <= laddr;
      laddr  <= ADDR;

    end if;

  end process clock;
end Behavioral;
