somaproject/network/(commit log)

2003-03-27 First-approximation of memory controller; works in behavioral and translate sims. Can't do others because there is insufficnet IO on any synthesizable devices. Use really cool ZBT vhdl behavioral mod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
2003-03-30 ALU functions, reg file functions, about to begin modifying ALU for better timing. Currently it takes 16.7 ns, ouch
2003-03-30 Switching to computation with separate units (ALU, Logic, and shift) and using mux on output saved 2 ns
2003-03-30 CPU mostly done, will synthesize/translate with a period of 25 ns without too much difficulty in an XC2S50E device
2003-03-31 Upgraded to a 32-bit processor. We're having some trouble meeting the 30 ns constraint in the -6 grade device, but the -7 grade device comes in under 27 ns minimum period. Now, oddly, a -6 grade devi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
2003-03-31 Device successfully adds to numbers; can be constrained to fit inside of a Spartan-IIE 50, which is great in terms of resource utilization. Now working on serial interface so we can easily load outpu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
2003-03-31 Can successfully assemble simple adder, in test.asm.pl
2003-04-04 Testbench correctly reads in .hex assembled code
2003-08-10 basics of Network TX input working; now to add the NEWFRAME reset code and hopefully not slow things down too much. Currently will synthesize, P&R at 160 Mhz!
2003-08-11 Beginnings of GigE card, made much easier by previously figuring out what components I wanted for the old MACandPHY appraoch.
    [FPGA.SCHDOC, Network Interface.PRJPCB, PHY.SCHDOC, memory.SCHDOC]
2003-08-11 Schematics mostly done; now time to PCB!
    [FPGA.SCHDOC, Power and Clocks.SCHDOC]
2003-08-12 Schematic done; PCB layed out and passing DRC with flying colors. I'd love to verify the sizes on those larger tantalum caps -- I could probably go with some smaller ones there, but oh well.
    [FPGA.SCHDOC, MAIN.SCHDOC, NIC.PCBDOC, Network Interface.PRJPCB, PHY.SCHDOC, Power and Clocks.SCHDOC, memory.SCHDOC]
2003-08-12 Done, with new capacitors, LDOs which actually work, and large electrolytics. Standardized on a bus architecture for the HD68 connector
    [FPGA.SCHDOC, NIC.PCBDOC, Network Interface.PRJPCB, PHY.SCHDOC, Power and Clocks.SCHDOC]
2003-08-13 reannotated part numbers on PCB
    [NIC.PCBDOC]
2003-08-25 Well, we're almost there! CRC errors are the big issue at the moment -- there is some really funky bit-manipulation stuff going on and we need to check it out. The issue is that the CRC is to be sent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
2003-08-25 We can transmit packets correctly of 12, 13, 14, and 15 bytes, and I assume this will generalize to larger packets :) FRAMETX signal is useful for counters.
2003-09-09 RXinput_memio debugging has progressed; timing and synthesis work.
    Overview modified to reflect current system design.
2003-09-13 Some additional notes on software, camera
    Designed RX output side-- again, crossing clock boundaries sucks.
2003-09-16 created network.vhd, overview to begin complete system integration.
    Cleaned up the naming of a lot of signals, so there's system-wide uniformity.
    Added clock-boundary-crossing logic to soma network tx input; better-commented protocol in readme.txt.
    Added pullup resistor for I2C MII management interface on PCBs for network.
    [NIC.PCBDOC, PHY.SCHDOC]
2003-09-20 Modified some systems to meet timing constraints; network will synthesize at 7.5 ns, but that's just really really tight. I think I'll work on functional benchmarks and test vectors for a while.
    [memory.vhd, network.vhd]
2003-09-21 Wow, this was a hell of a lot of work. We've created a testbench and begun debugging larger chunks of the system. in particular, we've added fifocheck to prevent the system FIFOs from overwriting the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
    [network.vhd]
2003-09-23 Fixed memory problem -- I really did need to CE the DQs on their actual CEs. (i.e. D1 on CLKEN1, etc)
    Really screwed with the timing and layout of RX_Output, and now it works as expected. I think I know what that is.
    Added pins to network.ucf.
    Wow, entire thing synthesizes after I added the pins. Thats so funny -- i must have gained 500 ps just by placing the output pins logically.
    Device will both send and receive packets, and does correct (I think) CRC checking.
    [memory.vhd, network.vhd, test_NoBLSRAM.vhd]
2003-09-23 Fixed a few small issues with both PCBs, including renaming of parts designators and making sure top overlay silkscreen wasn't covering up solder pads :) The folder mask expansions here are 4 mil, wh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
    Generated output gerbers, zipped them, let's rock and roll!
    [NIC.PCBDOC, Network Interface.PRJPCB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]
2003-09-23 A great day.
    Got system TXing and RXing packets. Wrote some great test vector code, so we can directly diff input and output.
    Big problem: at the moment, RX_output will, after a certain packet or two, essentially skip a word and accidentally set its BP too high. This causes it to read in the value after the BP as the length, and all hell breaks loose.
    This could be due to a few things. First, since I'm using the output of the TX_OUT section (GMII vectors are compatable that way), I occasionally get packets separated by a _single cycle_ of TX_EN being 0. Now, I can't find much in the spec, but I'm pretty sure this is legal.
    Therefor, the current thought is maybe RX_INPUT isn't handling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
    [test_NoBLSRAM.vhd]
2003-09-24 Got rid of FCS being included in received frame by simply subtracting values frmo BP and byte count.
    Having trouble synthesizing ... grr. Fixed it by pipelining LENR rounding.
    Wow, the system drops frames if the RX_CLK is too fast, but that's it... everything else seems to work. That's just incredible .
2003-09-25 Strange crc errors, and darn it, that .do file and modelsim have some strange ideas about compiling. But it all works now.
    [network.vhd]
2003-09-28 So, the new architecture essentially downclocks the internal control structures. Created a testbench that sends commands; created phyreset signal. Oh, made counters _and_ data 32-bits, which might ma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
2003-09-30 Oh god, what have I done?
    Added testbench; changed some stuff around so it synthesizes correctly and the post-P&R simulation works. I really hope things aren't that fubar'd in the rest of the system
    Upgraduing to ISE 6.1, because I like pain!
    Of course, the upgrade was less than totally successful, changing a bunch of file formats and the like in the process, and making things type-sensitive that weren't before, and (drumroll) not synthesizing to the timing constraints! Sux0r!
    So, the clkio signal is working now, but at first look, the BPs are all fucked up, no idea how to fix that.
    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
    [Network Interface.PRJPCB]
2003-10-03 added extra registers to TX_input to meet timing constraints; Put registers around everything remotely related to CRCs in RX_input_memio. Had to add two states to the FSM to get the timing right, but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
2003-10-04 It compiles, ship it!
    There has basically been NO REAL TESTING of the PHYstatus interface. None. It synthesises without any obvious bugs, but that's all you get.
    [control.vhd]
2003-10-05 Wow! Made overview.ai not suck; connected pretty much everything necessary at the top level of network.vhd. Now I'm going to try and implement MAC address filtering in the RXinput section.
2003-10-06 Wow, the whole bloody thing synthesizes at under 7.1 ns. Awesome.
    added MAC address detecteion
    created flag to allow reception of all frames.
    Created BOM code to output nice-looking excel BOMs
    [Network Interface.xls, PHY.SCHDOC]
2003-10-07 So, somewhat comically, we find out that IOB register packing will only happen if the signals feeding into the IOB component have NO RESET SIGNAL. This means THEY NEED THEIR OWN PROCESS!
    [Network Interface.xls]
2003-10-07 I hate you, AMP They obsoleted one of my 68 pin connectors and don't have a pin-compatable replacement thus we are going with molex connectors:
    Connector notes:
    Switching to Molex, series 71660/71661
    71161-2068 right-angle plug connector, 68-connector
    15-92-1468 vertical receptical connector, 68-pin
    for the dev board
    87552-0681 right-angle recepticale connector, 68 pin (samples from molex)
    Which the first and third of which have been added to the parts in this commit.
    [network.vhd]
2003-10-07 Updated Network interface to use Molex connector!
    [FPGA.SCHDOC, NIC.PCBDOC]
2003-10-09 Created a simulation of physical p&R output. It works :) wheee.
    Created a genralized frame command, which can generate (hopefully) valid ethernet frames.
2003-10-11 Almost done with frames.
2003-10-11 Created allframes megavector following getting frames.pl to work. Now to test.
2003-10-12 Can now filter frames, output correct GMII data
    Still having fundamental problems with the RXinput_gmii fifo, but that's not going away, and I'm making a design decision of "i'm not going to spend a day+ just so I can push receive speeds past 800 Mbps. " I increased the FIFO size; things still synthesize fine. Deal.
    I am now going to attempt to further-distribute the documentation for this project. This requires a pretty severe moving of, well, the entire "docs" tree into the various sub-projects. Wish me luck.
    [control.vhd]
2003-10-12 So, here's half of our attempt to move the documentation around. I hope this won't break stuff too much. Don't forget to rename hardware/docs to hardware/docs/BOM.gnumeric
2003-10-19 Changed ACT to LINK
    [NIC.PCBDOC]
2003-10-23 Updated Network outs, etc. to reflect new power packages. Added testing.txt to describe test suite.
    [FPGA.SCHDOC, NIC.PCBDOC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]
2003-10-24 A few small PCB changes with part names created assembly.txt for notes on physical assembly created testing.txt with notes on our test suite and methodology. Regenerated the BOM.
    [FPGA.SCHDOC, NIC.PCBDOC, Network Interface.xls, Power and Clocks.SCHDOC]
2003-10-29 Code largely written, stopping for a bit to clarify some network endian issues.
    [ping.vhd, rambuffer.vhd]
2003-10-29 Made surprisingly few changes to get effective endianness... note now that DIN[15:8] is the first byte on the wire. I wonder how badly this breaks, well, everything...
    [Network Interface.xls]
2003-10-29 So, the MAC will synthesize using the current UCF with a 7.2 ns period in a 200 device. This is with Optimization-across-hierarchy off and timing-driven-mapping on. But, i'm not sure it's optimizing 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
2003-10-29 Updated molex 68-pin connector and a few traces .
    [NIC.PCBDOC]
2003-10-29 Updated OSC TS pin.
    [NIC.PCBDOC, Power and Clocks.SCHDOC]
2003-11-02 Lots of fighting with the ram. Now we're turning to the PHY.
    [NIC.PCBDOC]
2003-11-08 Minor updates to frame data, changed testsuite to actually work.
2003-11-11 Wow, so much work! Create the test suite receiver to let us receive a single packet. Things work, mostly, except that some _really strange_ clock issues related to constraints on BUFGs are forcing me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
    [control.vhd]
2003-11-14 Wow, so, we're really really close to having things work.
    The testsuite can send packets, we can read and talk to the phy (don't forget that PHY reg 0 needs to = 0x1140 for things to work!), the ram test passes, everything is chipper.
    But, alas, once we constrained all the pins, things no longer seem to want to synthesize. Worse, it may have been _better_ to not use a clock enable for the control interface. We'll see.
    Current attempt is to try and free up some registers so that P&R has a bit more flexibility.
    [NIC.PCBDOC, PHY.SCHDOC]
2003-11-17 Wel, there are som pretty serious issues with transmitting. Outping simply sends output ping packets, but they're not doing all that well. Sometimes it misreads an address and goes into a nasty loop,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
    [control.vhd, network.vhd, outping.vhd, ping.vhd, serial.vhd]
2003-11-20 Wow, so, we've finally learned the benefits of the multipass place and route.
    outping was created to let us test the basic output interface.
    par_extract aggregates the data from a bunch of MPPR files.
    Created new layout to use the DLL's FB pin, added some caps
    Modified TXoutput to be more registered.
    Shifted from CLKSL to CLKSLEN
    [FPGA.SCHDOC, NIC.PCBDOC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]
2003-12-07 Created the LFSR memory2 interface to further verify memory errors. Wow, it works. Holy crap!
    [test_NoBLSRAM.vhd]
2003-12-11 Wow, lots of small changes.
    Added io.tx.frame.3.dat so we can sim correctly
    Added memdebug to let us look at memory.
    Currently the system will send pings from outping, although sometimes it seems to drop them. Need to work on that.
    Oh, and simply RLOCing the blockselect+ rams made timing improve!!!
    [control.vhd, memdebug.vhd, network.vhd, outping.vhd, test_NoBLSRAM.vhd]
2003-12-20 Wow, lot's of changes. Still trying to nail down that TX-input bug -- going to redesign clock-crossing code to see if that's where the problem is.
    [NIC.PCBDOC, Network Interface.PRJPCB]
2004-07-04 Updated schematics for S-3 began re-layout of PCB god, this is boring
    [FPGA.SCHDOC, MAIN.SCHDOC, NIC.PCBDOC, PHY.SCHDOC, Power and Clocks.SCHDOC, memory.SCHDOC]
2004-07-06 Finished; design passes drc.
    [FPGA.SCHDOC, NIC.PCBDOC, Network Interface.PRJPCB]
2004-10-10 Code successfully passes TX output simulation. Now onto TX input to see if it will put the data into RAM correctly...
    [NIC.PCBDOC, Network Interface.PRJPCB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]
2004-10-17 Control test works; figured out some endian problems with the MII management interface; also realized that PHYSTAT takes a bit to be updated.
    [controltest.vhd, miitest.vhd]
2004-11-07 Wow, simulation code initially correct; simple frames read correctly.
    [GMIIinsim.vhd, rxinput.py, rxinputtest.vhd, rxoutput.py, rxoutputtest.vhd]
2004-11-07 Somewhat interesting testbench bug; fixed now.
    [rxoutput.py, rxoutputtest.vhd]
2004-11-08 Updated network to no longer use clk feedback updated .ucf file with correct pinouts mostly completed new overview.
    [control.vhd, network.vhd]
2004-11-12 Overview.svg still needs signals labeled Creating master simulation to simulate everything.
    [FPGA.SCHDOC]
2004-11-19 Currently, we can transmit using ping/outping.vhd over the NIC interface. We are sending ping packets, which are encoded in some block ram. In order to turn on the phy we must write 1140 to phy regis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
    [network.vhd, outping.vhd]
2004-11-20 All test bench packages pass. We can use outping to tx, and in many cases receive and verify frames.
    Docs need some updating and love. And we need to Measure RX speed, although TX appears to have no problems.
    We also need clarity on the exact role of the competing input clocks and relative phase requirements.
    [network.vhd, outping.vhd, ping.vhd]
2006-06-12 * not sure what these are, but why not?
    [NIC.PCBDOC, Network Interface.PRJPCB]
2006-06-20 * Device doesn't build properly, yet.
    [NoBLSRAM.vhd, memtest.vhd, network.vhd, phytest.vhd, txinputtest.vhd]
2006-06-20 * Completed the MIItest and upgraded to modern sim framework
2006-06-22 * Functional phytest -- sends real frames
2006-06-26 * Update passes new big-endian redesign
    [GMIIinsim.vhd, rxinput.py, rxinputtest.vhd]
2006-08-09 * updated control to now transmit base pointers through serial interface * Added pulldown on NEXTFRAME input to try and debug some SI issues
    [control.vhd, network.vhd, sourcefilter.vhd]
2006-08-30 * Added correctly-placed mounting holes, using correct pads * added fudicials * Transitioned to new TPS795XX power converters * Added extra bypass caps * New 100-mil pitch mail header for connection 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
    [FPGA.SCHDOC, MAIN.SCHDOC, NIC.PCBDOC, Network Interface.PRJPCB, PHY.SCHDOC, Power and Clocks.SCHDOC, parts.PCBLIB, parts.SCHLIB]
2006-09-08 * updated docs...
    [NIC.PCBDOC]
2006-09-09 * clened up power connectors, passive to standard * added board cut outline
    [FPGA.SCHDOC, NIC.PCBDOC, PHY.SCHDOC, Power and Clocks.SCHDOC, memory.SCHDOC, parts.PCBLIB]
2006-09-09 *component pinout reduction
    [Network Interface.PRJPCB]
2006-09-10 * updates in the printout
2006-09-16 * moved Network Interface to pcb
    [FPGA.SCHDOC, MAIN.SCHDOC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]
2006-09-16 * yea, this is a bit painful.
    [NIC.PCBDOC, Network Interface.PRJPCB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]
2006-09-16 * outputs
    [NIC.DRL, NIC.GBL, NIC.GBO, NIC.GBP, NIC.GBS, NIC.GTL, NIC.GTO, NIC.GTP]
2006-09-18 * Update to network project
    [Network Interface.PRJPCB]
2006-09-19 * added BOMs, pick-and-place
    [BOM.html-Network Interface.PRJPCB, BOM.text-Network Interface.PRJPCB, BOM.xls-Network Interface.PRJPCB]
2006-11-11 * so much broken crap
    [BOM.xls-Network Interface.PRJPCB]
2006-12-08 * sigtest works, passes * fixed numerous little errors on schematic * updated docs to reflect correct value in frame LEN header * rebuilt, recompiled, added some debugging crap.
    [FPGA.SCHDOC, NIC.PCBDOC, Network Interface.PRJPCB, PHY.SCHDOC]
2006-12-20 ping works with current memory configuration with occasional dropped packets.
    [NIC.PCBDOC]
2006-12-27 * doc changes; we're going to do this in a more organized fashion now, because the current hap-hazard method is causing nothing but insanity
2006-12-27 Tx input totally passes all necessary tests; testbench covers necessary material
2007-01-12 * network test passes, but doesn't synth
    [idt71v3556.vhd, network.py, network.vhd, networktest.vhd, rxinput.vhd, rxoutput.vhd]
2007-01-13 * it should work but doesn't. Going to simplify tremendously.
    [memtest.vhd]
2007-01-28 * updates of models, etc. Trying to chase down timing sim errors.
    [memorytest.vhd, memtest.vhd, network.vhd, noblsram.vhd]
2007-02-05 * Minor pcb updates to try and add DCI to the device
    [FPGA.SCHDOC, NIC.PCBDOC]
2007-02-20 * added extra input registers to rxinput to fix problem with txiocrc error
    [network.vhd, rxinput.vhd, rxoutput.vhd, txinput.vhd, txoutput.vhd]
2007-02-23 * device appears to synthesize in time constraints but we still have the rXOF problem.
    [gmiiin.vhd, rxinput.vhd]
2007-02-26 * current gmiiin.2.datin rxinput2 has an example of a CRC error triggering due to an ovf; attempting to rectify.
    [rxinput.py, rxinputtest.vhd]
2007-03-02 * device synthesizes and works with TXMEMCRC enabled
2007-03-04 doesn't actually work; going to rewrite TX input
    [txinput.vhd]
2007-09-21 * regenerated outputs, fixing bug #19
    [BOM.html-Network Interface.PRJPCB, BOM.text-Network Interface.PRJPCB, BOM.xls-Network Interface.PRJPCB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]
2007-09-21 * updated version text to 1.2.1, copyright to 2007
    [BOM.xls-Network Interface.PRJPCB, NIC.PCBDOC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]
2007-10-12 * updated nic bomdb
    [NIC.PCBDOC]
2007-10-12 * added output tracking * updated some parts
    [FPGA.SCHDOC, Network Interface.PRJPCB, PHY.SCHDOC, network.bomdb.ods]
2007-10-22 * CSV BOM
    [Network Interface.PRJPCB, network.bomdb.ods]
2008-04-04 * added TXIOCRCERRCNT in an attempt to diagnose / debug the current packet drop problem
    [control.vhd, network.vhd, txinput.vhd]
